Arioner923/smart-greenhouse-controller/hardware/relay_test/evidence/relay-active-high-hardware.jpg

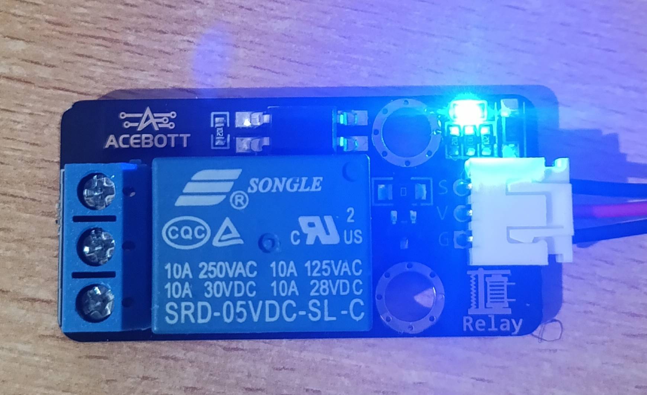
hardware/relay_test/evidence/relay-active-high-hardware.jpg
