Arioner923/smart-greenhouse-controller/hardware/README.md

# Hardware

Prototype hardware documentation and standalone validation sketches.

The sketches in the subfolders were used to validate individual hardware
functions before they were integrated into the main firmware. The current
validated wiring is documented in `../docs/wiring.md` and `shield.md`.
