Arioner923/smart-greenhouse-controller/docs/README.md

# Documentation

Technical documentation for the Smart Greenhouse Controller.

- `software-architecture.md` — current firmware architecture and module responsibilities
- `wiring.md` — validated prototype wiring, power and pin assignments
