Arioner923/smart-greenhouse-controller/hardware/bme280_readings/evidence/bme280-reading-pass.png

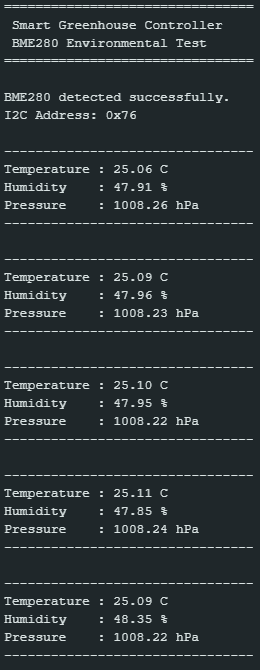
hardware/bme280_readings/evidence/bme280-reading-pass.png
