Arioner923/smart-greenhouse-controller/hardware/i2c_scanner/evidence/i2c_scanner_pass.png

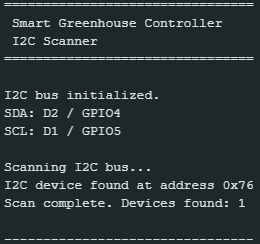
hardware/i2c_scanner/evidence/i2c_scanner_pass.png
