Arioner923/smart-greenhouse-controller/hardware/sensor_identification/evidence/sensor-identification-pass.png

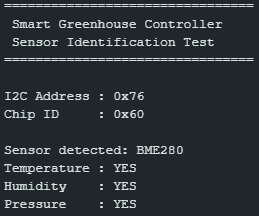
hardware/sensor_identification/evidence/sensor-identification-pass.png
