Arioner923/smart-greenhouse-controller/validation/evidence/auto-manual-modes-pass.png

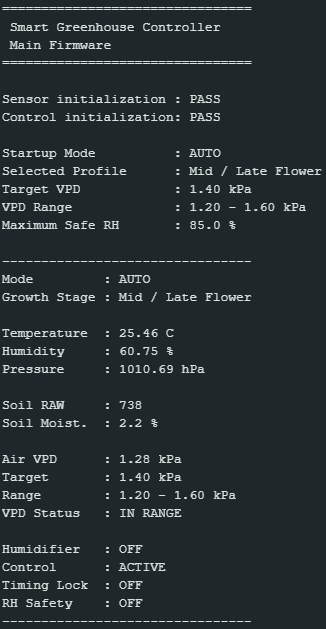
validation/evidence/auto-manual-modes-pass.png
