Arioner923/smart-greenhouse-controller/validation/test-plan.md

# Hardware Validation Test Plan

This document defines the initial validation procedure for the Smart Greenhouse Controller prototype.

## Test Environment

Controller:

- WeMos D1 R2 V2.1.0
- ESP8266

Connected hardware:

- GY-BME/P280 environmental sensor
- Capacitive soil moisture sensor
- ACEBOTT 5V relay module

Current shield connections:

| Function | WeMos Pin | ESP8266 GPIO |
|---|---|---|
| BME280 SCL | D1 | GPIO5 |
| BME280 SDA | D2 | GPIO4 |
| Soil Sensor Analog | A0 | ADC |
| Relay Signal | D5 | GPIO14 |

---

# Test 01 - ESP8266 Boot Test

## Objective

Verify that the WeMos D1 R2 boots correctly with the prototype shield installed.

## Procedure

1. Disconnect all mains-voltage equipment.
2. Connect the WeMos D1 R2 to the computer through USB.
3. Open the Serial Monitor.
4. Verify that the ESP8266 boots normally.

## Expected Result

The board boots without:

- Continuous resets
- Abnormal heating
- USB disconnections

## Result

The ESP8266 booted normally with the prototype shield installed.

No continuous resets, abnormal heating or USB disconnections were observed.

## Status

- [x] PASS
- [ ] FAIL

---

# Test 02 - I2C Bus Scan

## Objective

Verify communication between the ESP8266 and the environmental sensor.

## Connections

    D1 / GPIO5 -> SCL
    D2 / GPIO4 -> SDA

## Procedure

1. Upload the I2C scanner firmware.
2. Open Serial Monitor.
3. Scan the I2C bus.

## Expected Result

At least one I2C device should be detected.

Expected BME280/BMP280 address:

- 0x76
- 0x77

## Result

Devices detected:

    1

Detected I2C address:

    0x76

The environmental sensor responded consistently during repeated I2C scans.

## Status

- [x] PASS
- [ ] FAIL

---

# Test 03 - Environmental Sensor Identification

## Objective

Determine whether the installed GY-BME/P280 module contains a BME280 or BMP280 sensor.

## Expected Result

The firmware should identify the sensor correctly.

A BME280 provides:

- Air temperature
- Relative humidity
- Atmospheric pressure

## Result

Detected sensor:

    BME280

I2C address:

    0x76

Chip ID:

    0x60

Supported measurements:

    Temperature : YES
    Humidity    : YES
    Pressure    : YES

## Status

- [x] PASS
- [ ] FAIL

---

# Test 04 - Environmental Measurements

## Objective

Verify valid environmental sensor readings.

## Measurements

- Air temperature
- Relative humidity
- Atmospheric pressure

## Expected Result

Values should be stable and physically reasonable.

## Results

Temperature:

    25.06 - 25.11 °C

Relative Humidity:

    47.85 - 48.35 %

Pressure:

    1008.22 - 1008.26 hPa

The measurements remained stable during the observation period.

## Status

- [x] PASS
- [ ] FAIL

---

# Test 05 - Soil Sensor Raw ADC Test

## Objective

Verify that the ESP8266 can read the analog signal from the capacitive soil
moisture sensor through the A0 input.

## Connection

    Soil Analog Output -> A0

## Procedure

1. Power the soil moisture sensor from 3.3V.
2. Keep the sensor outside the soil.
3. Read the raw ADC value from A0.
4. Observe the reading for approximately 20-30 seconds.
5. Verify that the value is stable and is not permanently stuck at 0 or 1023.

## Results

Sensor condition:

    Air / not inserted into soil

Observed RAW range:

    734 - 746

Typical stable RAW value:

    746

## Result

The analog input responded correctly and the sensor produced a stable ADC
reading.

## Status

- [x] PASS
- [ ] FAIL

---

# Test 06 - Soil Sensor Calibration

## Objective

Determine calibration reference values for the capacitive soil moisture sensor
and validate its response under real soil conditions.

## Calibration References

Air reference:

    746

Water reference:

    390

These values define the relative calibration scale:

    0%   = Air reference
    100% = Water reference

## Real Soil Validation

Dry soil:

    Representative RAW value: 744

Well-watered draining soil:

    Observed RAW range: 469 - 481

The well-watered soil measurement confirms that the sensor responds correctly
between the dry and fully saturated reference points.

## Calibration Notes

The calculated percentage represents a relative moisture scale based on the
sensor calibration.

It does not represent an absolute volumetric water content measurement.

## Status

- [x] PASS
- [ ] FAIL

---

# Test 07 - Relay Trigger Test

## Objective

Verify control of the ACEBOTT relay module from D5 / GPIO14.

## Safety

No 230V AC load was connected during this test.

## Procedure

1. Set D5 LOW.
2. Observe relay LED and relay click.
3. Set D5 HIGH.
4. Observe relay LED and relay click.
5. Determine the trigger logic.

## Result

Relay type:

- [x] Active HIGH
- [ ] Active LOW

Observed behavior:

    LOW  -> Relay OFF
    HIGH -> Relay ON

The relay LED turned on and the relay clicked when GPIO14 / D5 was set HIGH.

## Status

- [x] PASS
- [ ] FAIL

---

# Test 08 - Combined Hardware Test

## Objective

Verify that all currently installed devices operate correctly at the same time.

## Devices

- BME280
- Soil moisture sensor
- Relay module

## Result

All currently connected devices operated correctly at the same time.

Observed values:

    Temperature : 26.04 °C
    Humidity    : 45.41 %
    Pressure    : 1006.75 hPa
    Soil RAW    : 463
    Soil Moist. : 79.5 %
    Relay       : OFF

The relay initialized in the safe OFF state.

## Status

- [x] PASS
- [ ] FAIL

---

# Test 09 - VPD Calculation

## Objective

Calculate Vapor Pressure Deficit using measured air temperature and relative humidity.

## Requirement

This test requires a confirmed BME280 sensor.

## Result

Observed values:

    Temperature : 25.60 °C
    Humidity    : 45.99 %
    Pressure    : 1006.73 hPa
    VPD         : 1.77 kPa
    Soil RAW    : 473
    Soil Moist. : 76.7 %
    Relay       : OFF

The VPD calculation produced a valid result based on the measured air
temperature and relative humidity.

## Status

- [x] PASS
- [ ] FAIL

---

# Validation Summary

| Test | Status |
|---|---|
| ESP8266 Boot | PASS |
| I2C Scan | PASS |
| Sensor Identification | PASS |
| Environmental Measurements | PASS |
| Soil ADC | PASS |
| Soil Calibration | PASS |
| Relay Trigger | PASS |
| Combined Hardware Test | PASS |
| VPD Calculation | PASS |

---

## Validation Outcome

The initial hardware validation milestone was completed successfully.

The following functions have been verified:

- ESP8266 operation
- I2C communication
- BME280 identification
- Environmental sensing
- Soil moisture ADC acquisition
- Soil moisture calibration
- Relay control
- Simultaneous hardware operation
- Air VPD calculation

The prototype is ready to proceed to the modular firmware and automatic
VPD control development phase.

---

## Notes

Serial Monitor screenshots and selected hardware photographs are stored as
validation evidence.

Only experimentally verified results are marked as PASS.
