Arioner923/smart-greenhouse-controller/validation/README.md

# Validation

Hardware and firmware validation material for the Smart Greenhouse Controller.

- `test-plan.md` — initial hardware validation procedure and results
- `software-validation.md` — incremental firmware validation results
- `evidence/` — selected screenshots captured during validation

Evidence documents the state that was tested at each milestone; later refactors
may change implementation details without rewriting the historical result.
