Arioner923/smart-greenhouse-controller/hardware/combined_hardware_test/evidence/combined-hardware-test-pass.png

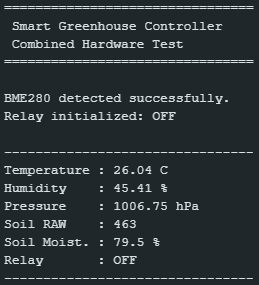
hardware/combined_hardware_test/evidence/combined-hardware-test-pass.png
