Arioner923/smart-greenhouse-controller/hardware/relay_test/evidence/relay-active-high-pass.png

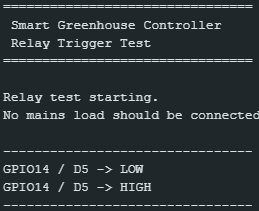
hardware/relay_test/evidence/relay-active-high-pass.png
