Arioner923/smart-greenhouse-controller/hardware/soil_calibration/evidence/soil-calibration-dry.png

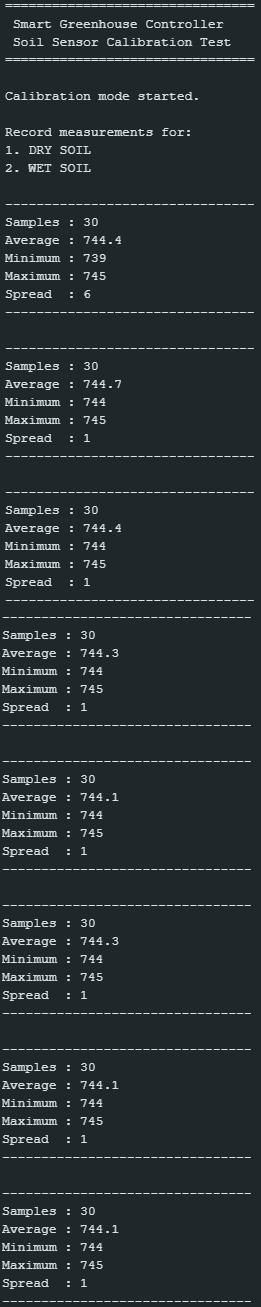
hardware/soil_calibration/evidence/soil-calibration-dry.png
