Arioner923/smart-greenhouse-controller/hardware/soil_calibration/evidence/soil-calibration-wet.png

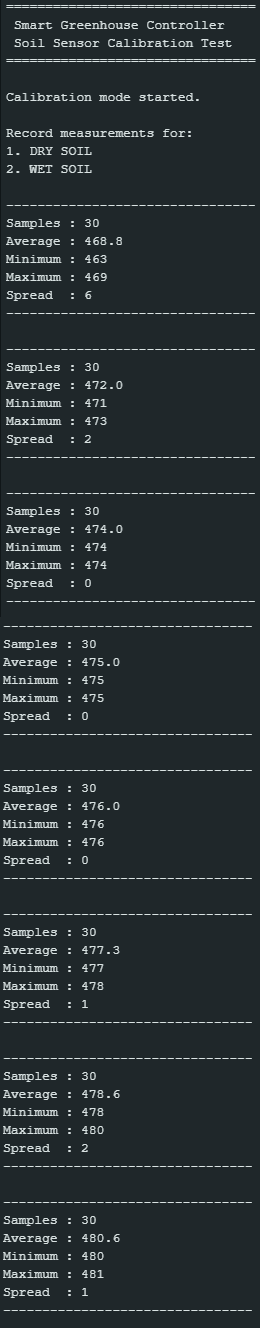
hardware/soil_calibration/evidence/soil-calibration-wet.png
