Arioner923/smart-greenhouse-controller/hardware/soil_raw_test/evidence/soil-adc-air-pass.png

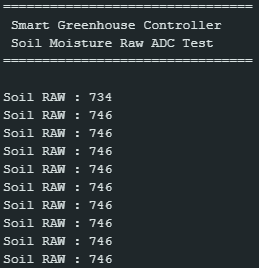
hardware/soil_raw_test/evidence/soil-adc-air-pass.png
