Arioner923/smart-greenhouse-controller/hardware/vpd_test/evidence/vpd-calculation-pass.png

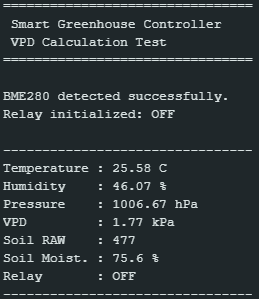
hardware/vpd_test/evidence/vpd-calculation-pass.png
