Arioner923/smart-greenhouse-controller/validation/evidence/automatic-vpd-control-pass.png

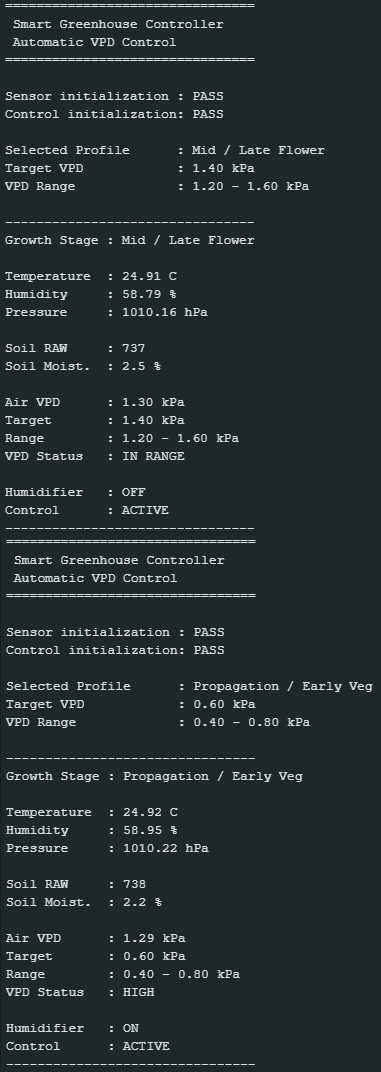
validation/evidence/automatic-vpd-control-pass.png
