Arioner923/smart-greenhouse-controller/validation/evidence/control-module-integration-pass.png

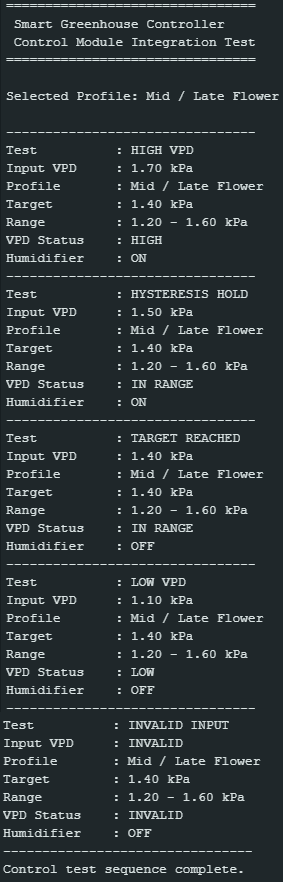
validation/evidence/control-module-integration-pass.png
