Arioner923/smart-greenhouse-controller/validation/evidence/growth-stage-runtime-selection-pass.png

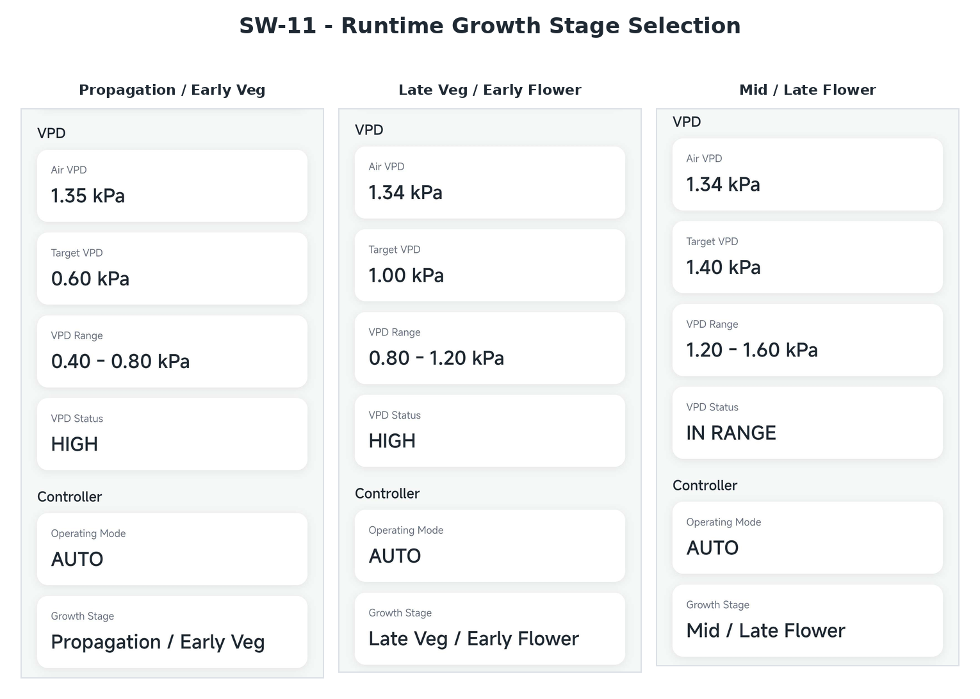
validation/evidence/growth-stage-runtime-selection-pass.png
