Arioner923/smart-greenhouse-controller/validation/evidence/local-web-dashboard-pass.png

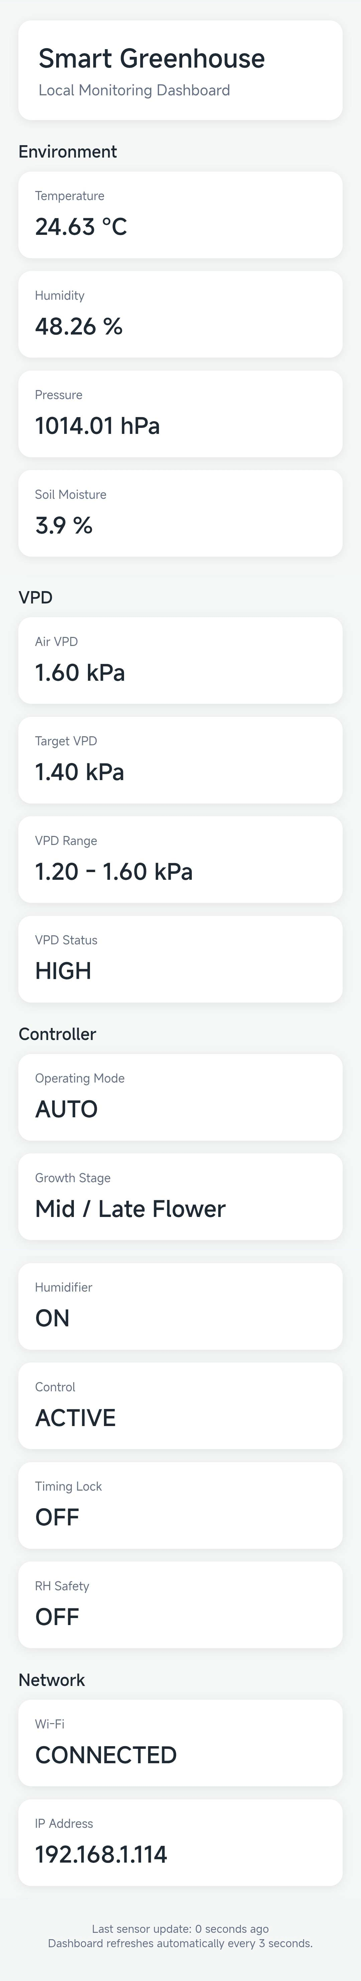
validation/evidence/local-web-dashboard-pass.png
