Arioner923/smart-greenhouse-controller/validation/evidence/relay-control-safety-pass.png

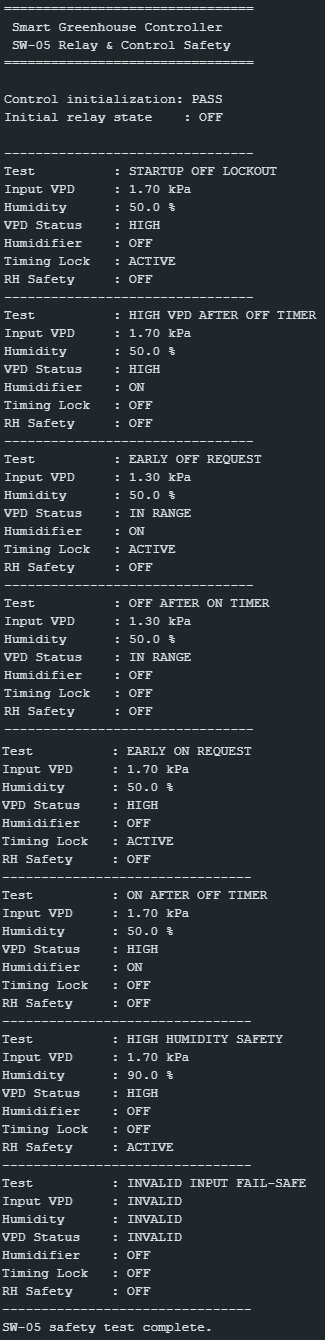
validation/evidence/relay-control-safety-pass.png
