Arioner923/smart-greenhouse-controller/validation/evidence/sensor-module-integration-pass.png

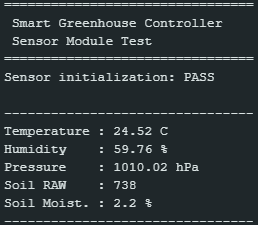
validation/evidence/sensor-module-integration-pass.png
