Arioner923/smart-greenhouse-controller/validation/evidence/soil-classification-pass.png

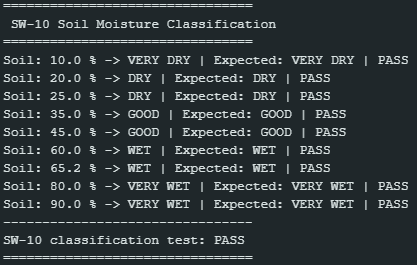
validation/evidence/soil-classification-pass.png
