Arioner923/smart-greenhouse-controller/validation/evidence/soil-moisture-status-pass.png

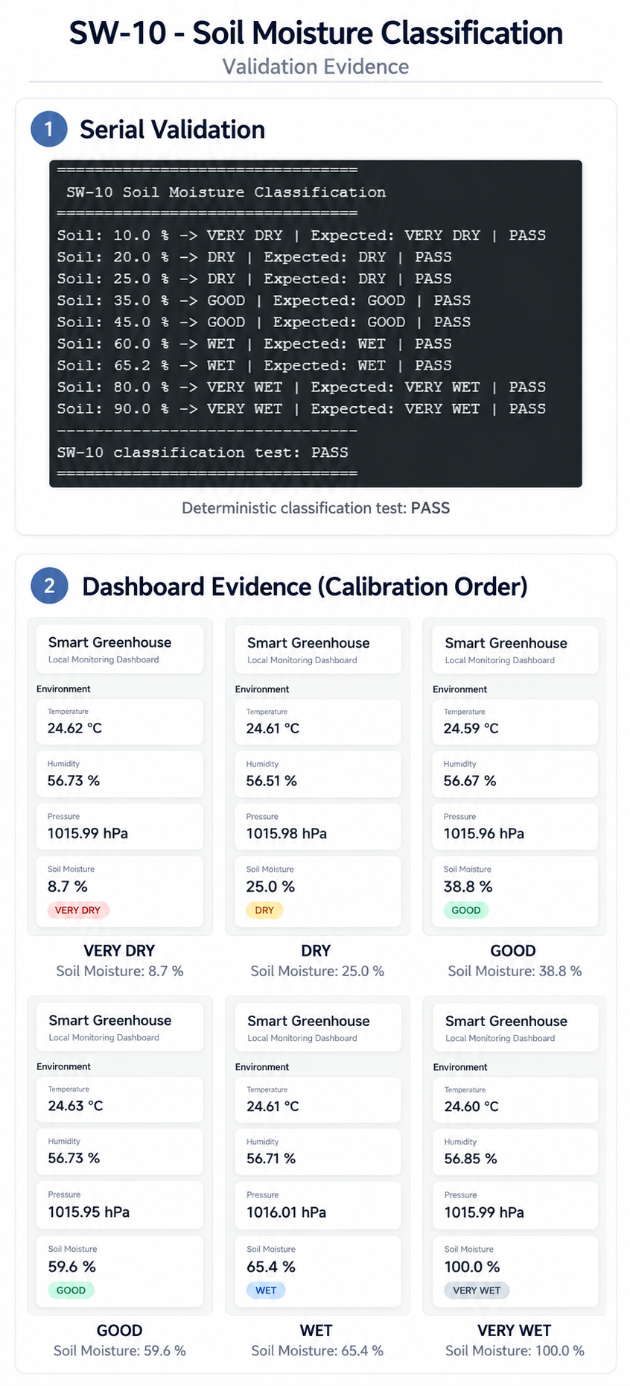
validation/evidence/soil-moisture-status-pass.png
