Arioner923/smart-greenhouse-controller/validation/evidence/vpd-module-integration-pass.png

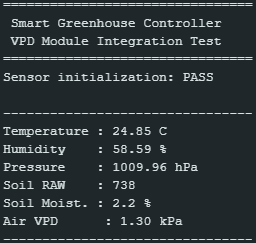
validation/evidence/vpd-module-integration-pass.png
