Arioner923/smart-greenhouse-controller/validation/evidence/web-control-pass.png

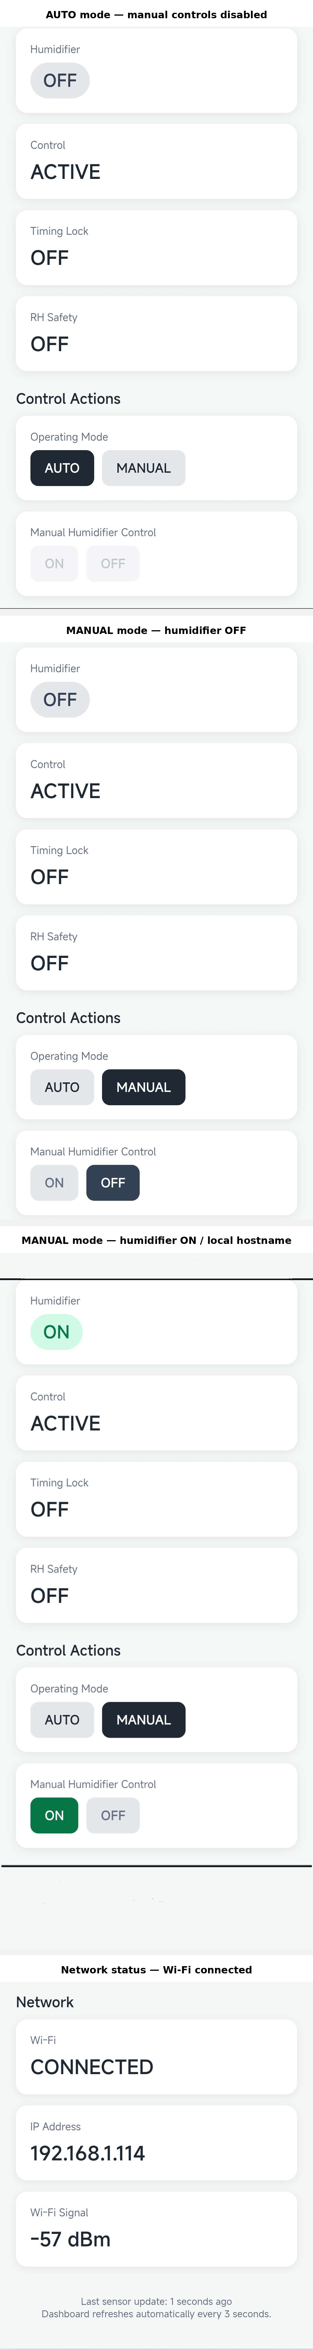
validation/evidence/web-control-pass.png
