Arioner923/smart-greenhouse-controller/validation/evidence/wifi-offline-reconnect-pass.png

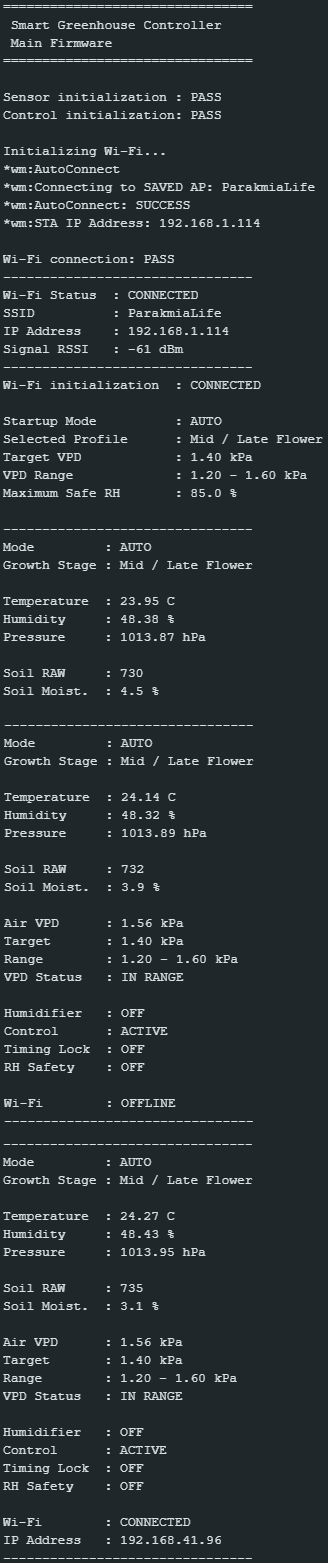
validation/evidence/wifi-offline-reconnect-pass.png
