Arioner923/smart-greenhouse-controller/validation/evidence/wifi-provisioning-pass.png

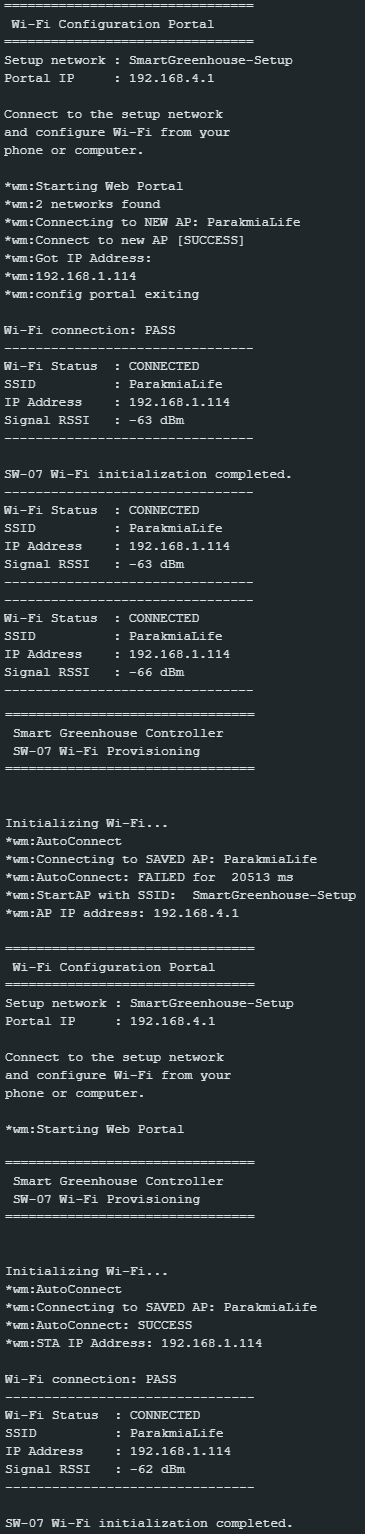
validation/evidence/wifi-provisioning-pass.png
