Arioner923/smart-greenhouse-controller/(commit log)

2026-10-16 docs: initialize smart greenhouse project README
    Add initial project overview, current hardware, shield pinout,
    development roadmap, validation checklist and copyright notice.
2026-10-16 docs: document prototype shield wiring
2026-10-16 docs: add detailed hardware wiring guide
2026-10-16 test: complete soil moisture calibration
2026-10-16 test: validate relay active-high operation
2026-10-17 feat: add sensor module and integration validation
2026-10-17 feat: add relay and control safety protections
2026-10-18 feat: add runtime growth stage selection
